jntaimo/2.004-Segway/Segway V7/Segway V7.step

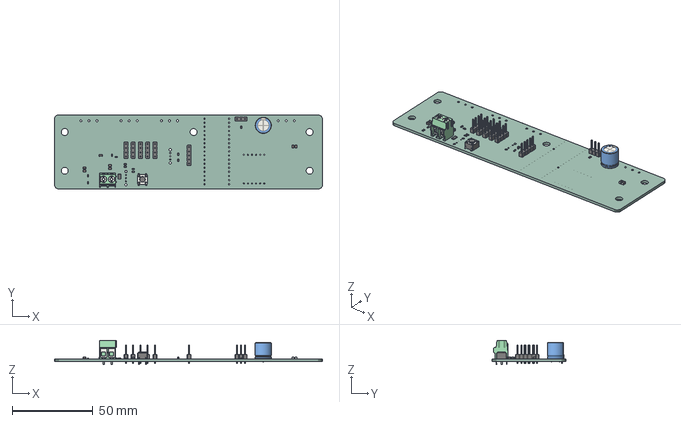
[picture p7: CAD file, 2024-01-22]
Segway V7/Segway V7.step
166.3 x 45.9 x 15.0 mm
PCB
