jntaimo/2.004-Segway/Segway V7/SPH0645LM4H-B/SPH0645LM4H-B.step

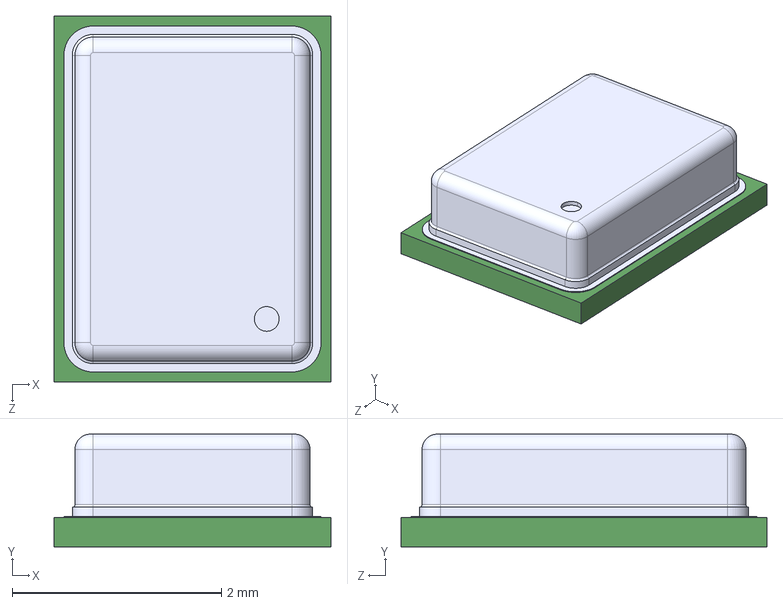
[picture p8: CAD file, 2024-01-22]
Segway V7/SPH0645LM4H-B/SPH0645LM4H-B.step
2.65 x 1.08 x 3.50 mm
