jntaimo/2.004-Segway/Segway V7/TCA9548APWR/TCA9548APWR.step

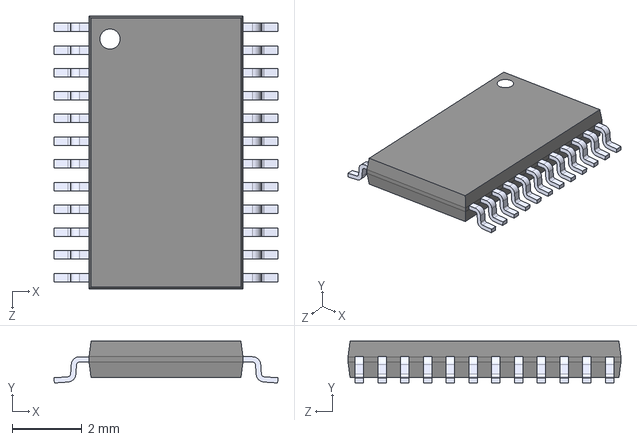
[picture p9: CAD file, 2024-01-22]
Segway V7/TCA9548APWR/TCA9548APWR.step
6.40 x 1.20 x 7.80 mm
