jntaimo/2.004-Segway/Segway V7/TPS564208DDCT/TPS564208DDCT.step

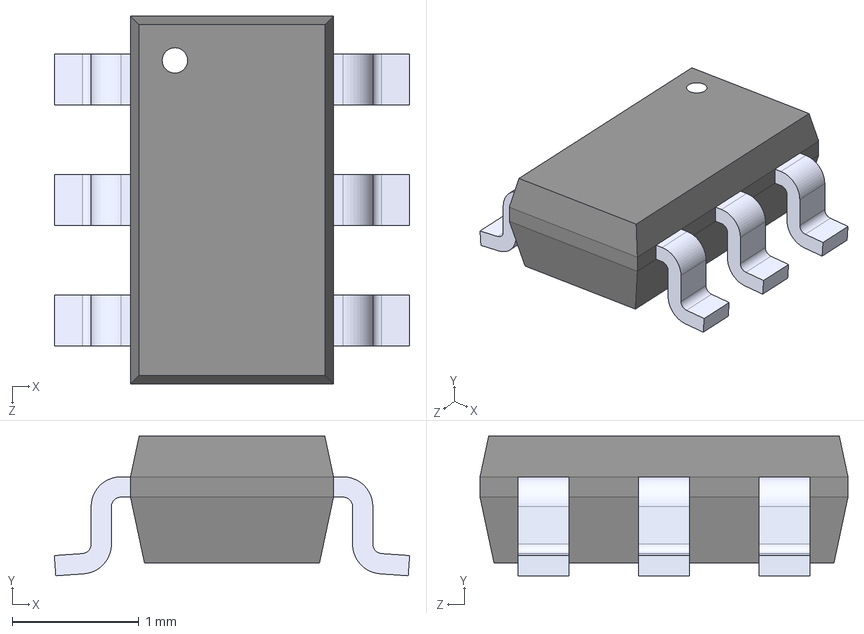
[picture p10: CAD file, 2024-01-22]
Segway V7/TPS564208DDCT/TPS564208DDCT.step
2.80 x 1.10 x 2.90 mm
