jntaimo/2.004-Segway/Segway V7/Segway V7.kicad_pcb

## KiCad design Segway V7/Segway V7.kicad_pcb (2024-01-22)

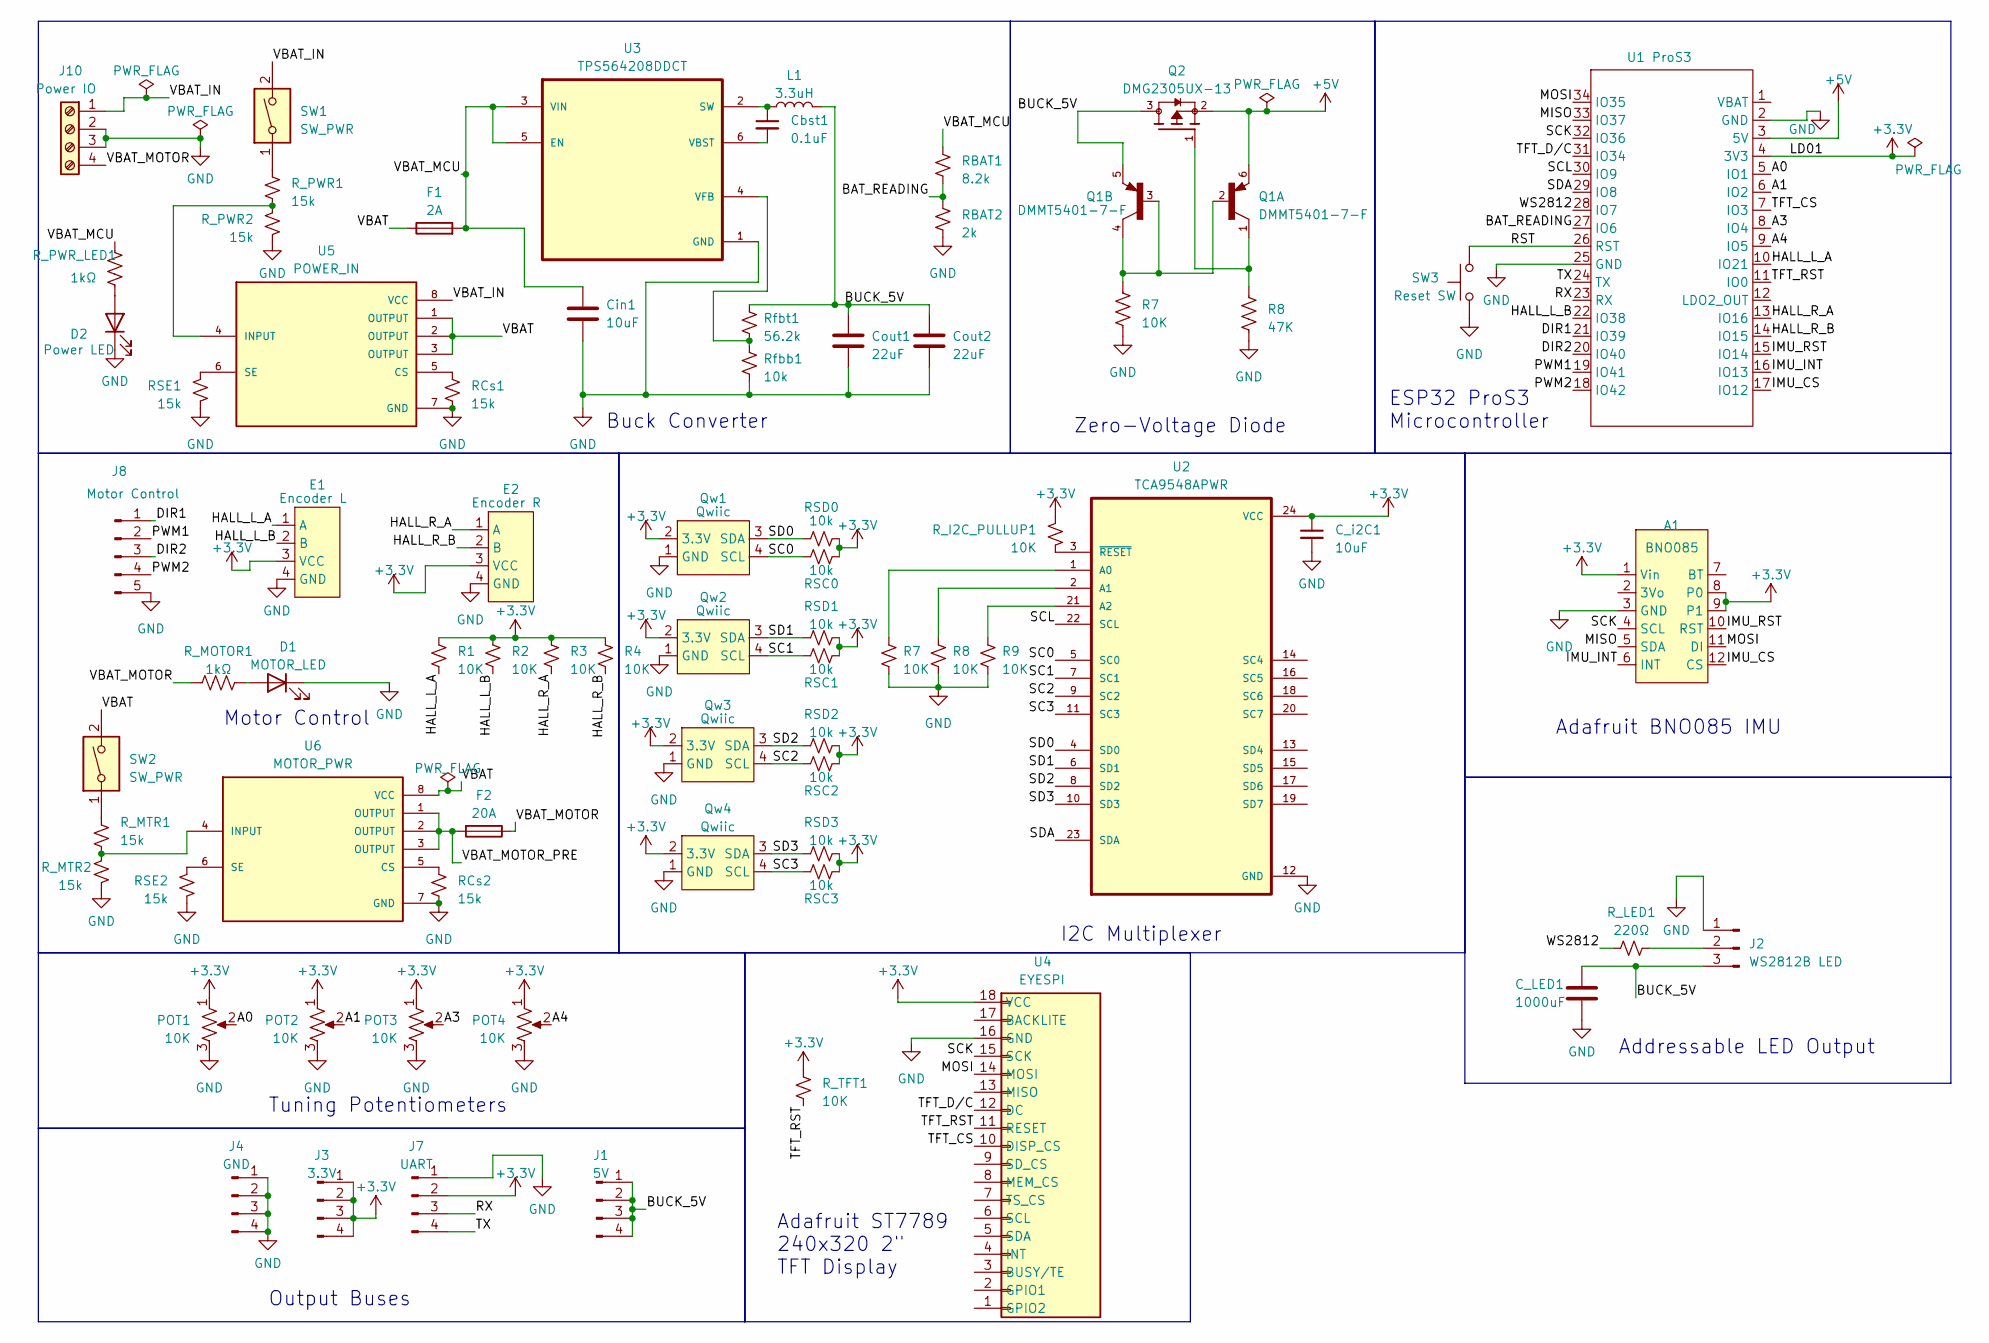
[picture p14: schematic Segway V7.kicad_sch, Segway Bot V7]

Parts:
A1: BNO085; Adafruit_BNO085
C_LED1: 1000uF; CP_Elec_10x12.6; MPN C250086
C_i2C1: 10uF; C_0805_2012Metric_Pad1.18x1.45mm_HandSolder; MPN C39232
Cbst1: 0.1uF; C_0805_2012Metric; MPN C519981
Cin1: 10uF; C_1210_3225Metric; MPN C39232
Cout1, Cout2: 22uF; C_1210_3225Metric; MPN C65428
D1: MOTOR_LED; LED_0603_1608Metric; MPN C434423
D2: Power LED; LED_0603_1608Metric; MPN C84263
E1: Encoder L; JST_PH_S4B-PH-SM4-TB_1x04-1MP_P2.00mm_Horizontal; MPN C265102
E2: Encoder R; JST_PH_S4B-PH-SM4-TB_1x04-1MP_P2.00mm_Horizontal; MPN C265102
F1: 2A; Fuse_1206_3216Metric; MPN C355683
F2: 20A; Fuse_1206_3216Metric; MPN C207007
J1: 5V; PinHeader_1x04_P2.54mm_Vertical
J2: WS2812B LED; PinHeader_1x03_P2.54mm_Vertical
J3: 3.3V; PinHeader_1x04_P2.54mm_Vertical
J4: GND; PinHeader_1x04_P2.54mm_Vertical
J7: UART; PinHeader_1x04_P2.54mm_Vertical
J8: Motor Control; PinHeader_1x05_P2.54mm_Vertical
J10: Power IO; TerminalBlock_Phoenix_MKDS-3-4-5.08_1x04_P5.08mm_Horizontal; MPN C3816378
L1: 3.3uH; L_Vishay_IHLP-4040; MPN C845075
POT1, POT2, POT3, POT4: 10K; JST_PH_B3B-PH-SM4-TB_1x03-1MP_P2.00mm_Vertical; MPN C265082
Q1: DMMT5401-7-F; SOT95P285X140-6N; PARTREV 8
Q2: DMG2305UX-13; SOT91P240X110-3N; PARTREV 09/2018
Qw1, Qw2, Qw3, Qw4: Qwiic; JST_SH_BM04B-SRSS-TB_1x04-1MP_P1.00mm_Vertical; MPN C160390
R1, R2, R3, R4, R7, R9: 10K; R_0402_1005Metric; MPN C144807
R8: 47K; R_0402_1005Metric; MPN C25792
RBAT1: 8.2k; R_0402_1005Metric; MPN C25924
RBAT2: 2k; R_0402_1005Metric; MPN C4109
RCs1, RCs2: 15k; R_0402_1005Metric; MPN C25756
RSC0, RSC1, RSC2, RSC3: 10k; R_0402_1005Metric; MPN C144807
RSD0, RSD1, RSD2, RSD3: 10k; R_0402_1005Metric; MPN C144807
RSE1, RSE2: 15k; R_0402_1005Metric; MPN C25756
R_I2C_PULLUP1: 10K; R_0402_1005Metric; MPN C144807
R_LED1: 220Ω; R_0402_1005Metric; MPN C25151
R_MOTOR1: 1kΩ; R_0402_1005Metric; MPN C21190
R_MTR1, R_MTR2: 15k; R_0402_1005Metric; MPN C25756
R_PWR1, R_PWR2: 15k; R_0402_1005Metric; MPN C25756
R_PWR_LED1: 1kΩ; R_0402_1005Metric; MPN C21190
R_TFT1: 10K; R_0402_1005Metric; MPN C144807
Rfbb1: 10k; R_0402_1005Metric; MPN C144807
Rfbt1: 56.2k; R_0402_1005Metric; MPN C183355
SW1, SW2: SW_PWR; JST_PH_B2B-PH-SM4-TB_1x02-1MP_P2.00mm_Vertical; MPN C160352
SW3: Reset SW; SW_PUSH_6mm
U1: ProS3; ProS3_TH
U2: TCA9548APWR; SOP65P640X120-24N; MPN C130026
U3: TPS564208DDCT; SOT95P280X110-6N; MPN C2070774
U4: EYESPI; Hirose_FH12-18S-0.5SH_1x18-1MP_P0.50mm_Horizontal; MPN C2856802
U5: POWER_IN; DPAK85P972X240-8N; MPN C2150194
U6: MOTOR_PWR; DPAK85P972X240-8N; MPN C2150194

Connections:
+3.3V: A1.1 (Vin), A1.8 (P0), A1.9 (P1), C_i2C1.1, E1.3 (VCC), E2.3 (VCC), J3.1, J3.2, J3.3, J3.4, J7.2, POT1.1, POT2.1, POT3.1, POT4.1, Qw1.2 (3.3V), Qw2.2 (3.3V), Qw3.2 (3.3V), Qw4.2 (3.3V), R1.1, R2.1, R3.1, R4.1, RSC0.2, RSC1.2, RSC2.2, RSC3.2, RSD0.2, RSD1.2, RSD2.2, RSD3.2, R_I2C_PULLUP1.1, R_TFT1.1, U1.4 (3V3), U2.24 (VCC), U4.18 (VCC)
+5V: Q1.6, Q2.2, U1.3 (5V)
/A0: POT1.2, U1.5 (IO1)
/A1: POT2.2, U1.6 (IO2)
/A3: POT3.2, U1.8 (IO4)
/A4: POT4.2, U1.9 (IO5)
/BAT_READING: RBAT1.2, RBAT2.1, U1.27 (IO6)
/BUCK_5V: C_LED1.1, Cout1.1, Cout2.1, J1.1, J1.2, J1.3, J1.4, J2.3, L1.2, Q1.5, Q2.3, Rfbt1.1
/DIR1: J8.1, U1.21 (IO39)
/DIR2: J8.3, U1.20 (IO40)
/HALL_L_A: E1.1 (A), R1.2, U1.10 (IO21)
/HALL_L_B: E1.2 (B), R2.2, U1.22 (IO38)
/HALL_R_A: E2.1 (A), R3.2, U1.13 (IO16)
/HALL_R_B: E2.2 (B), R4.2, U1.14 (IO15)
/IMU_CS: A1.12 (CS), U1.17 (IO12)
/IMU_INT: A1.6 (INT), U1.16 (IO13)
/IMU_RST: A1.10 (RST), U1.15 (IO14)
/MISO: A1.5 (SDA), U1.33 (IO37)
/MOSI: A1.11 (DI), U1.34 (IO35), U4.14 (MOSI)
/PWM1: J8.2, U1.19 (IO41)
/PWM2: J8.4, U1.18 (IO42)
/RST: SW3.1, U1.26 (RST)
/RX: J7.3, U1.23 (RX)
/SC0: Qw1.4 (SCL), RSC0.1, U2.5 (SC0)
/SC1: Qw2.4 (SCL), RSC1.1, U2.7 (SC1)
/SC2: Qw3.4 (SCL), RSC2.1, U2.9 (SC2)
/SC3: Qw4.4 (SCL), RSC3.1, U2.11 (SC3)
/SCK: A1.4 (SCL), U1.32 (IO36), U4.15 (SCK)
/SCL: U1.30 (IO9), U2.22 (SCL)
/SD0: Qw1.3 (SDA), RSD0.1, U2.4 (SD0)
/SD1: Qw2.3 (SDA), RSD1.1, U2.6 (SD1)
/SD2: Qw3.3 (SDA), RSD2.1, U2.8 (SD2)
/SD3: Qw4.3 (SDA), RSD3.1, U2.10 (SD3)
/SDA: U1.29 (IO8), U2.23 (SDA)
/TFT_CS: U1.7 (IO3), U4.10 (DISP_CS)
/TFT_D/C: U1.31 (IO34), U4.12 (DC)
/TFT_RST: R_TFT1.2, U1.11 (IO0), U4.11 (RESET)
/TX: J7.4, U1.24 (TX)
/VBAT: F1.1, SW2.2, U5.1 (OUTPUT), U5.2 (OUTPUT), U5.3 (OUTPUT), U6.8 (VCC)
/VBAT_IN: J10.1, SW1.2, U5.8 (VCC)
/VBAT_MCU: Cin1.1, F1.2, RBAT1.1, R_PWR_LED1.2, U3.3 (VIN), U3.5 (EN)
/VBAT_MOTOR: F2.1, J10.4, R_MOTOR1.1
/VBAT_MOTOR_PRE: F2.2, U6.1 (OUTPUT), U6.2 (OUTPUT), U6.3 (OUTPUT)
/WS2812: R_LED1.1, U1.28 (IO7)
GND: A1.3 (GND), C_LED1.2, C_i2C1.2, Cin1.2, Cout1.2, Cout2.2, D1.1 (K), D2.1 (K), E1.4 (GND), E2.4 (GND), J2.1, J4.1, J4.2, J4.3, J4.4, J7.1, J8.5, J10.2, J10.3, POT1.3, POT2.3, POT3.3, POT4.3, Qw1.1 (GND), Qw2.1 (GND), Qw3.1 (GND), Qw4.1 (GND), R7.2, R8.2, R9.2, RBAT2.2, RCs1.2, RCs2.2, RSE1.2, RSE2.2, R_MTR2.2, R_PWR2.2, Rfbb1.2, SW3.2, U1.2 (GND), U1.25 (GND), U2.12 (GND), U3.1 (GND), U4.16 (GND), U5.7 (GND), U6.7 (GND); also elsewhere on the board
unnamed: D1.2 (A), R_MOTOR1.2
unnamed: D2.2 (A), R_PWR_LED1.1
unnamed: J2.2, R_LED1.2
unnamed: R_MTR1.1, SW2.1
unnamed: R_PWR1.1, SW1.1
unnamed: R9.1, U2.21 (A2)
unnamed: R_I2C_PULLUP1.2, U2.3 (~RESET)
unnamed: Cbst1.1, L1.1, U3.2 (SW)
unnamed: Cbst1.2, U3.6 (VBST)
unnamed: Rfbb1.1, Rfbt1.2, U3.4 (VFB)
unnamed: RCs1.1, U5.5 (CS)
unnamed: R_PWR1.2, R_PWR2.1, U5.4 (INPUT)
unnamed: RSE1.1, U5.6 (SE)
unnamed: RCs2.1, U6.5 (CS)
unnamed: R_MTR1.2, R_MTR2.1, U6.4 (INPUT)
unnamed: RSE2.1, U6.6 (SE)

Notes on the sheet:
Motor Control
Output Buses
Zero-Voltage Diode
Adafruit ST7789 240x320 2" TFT Display
ESP32 ProS3 Microcontroller
I2C Multiplexer
Tuning Potentiometers
Buck Converter
Adafruit BNO085 IMU
Addressable LED Output

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
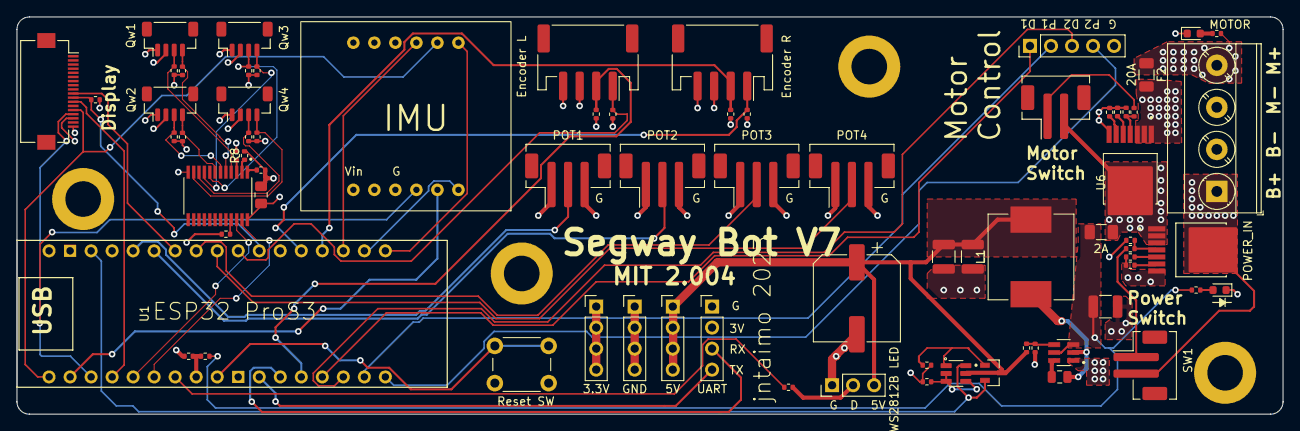
[picture p15: board Segway V7.kicad_pcb from above]

Board: 4 copper layers, 153.0 x 48.0 mm, 74 parts (0 on the bottom side), 65 nets.

Other parts of the board:
R_ZVD_1: 10K; R_0402_1005Metric
R_ZVD_2: 47K; R_0402_1005Metric

Their connections:
GND: R_ZVD_1.2, R_ZVD_2.2; also elsewhere on the board
