jntaimo/2.004-Segway/Segway V7/esp32s3-main/code/micropython/helper libraries/feathers3/feathers3.py

# FeatherS3 MicroPython Helper Library
# 2022 Seon Rozenblum - Unexpected Maker
#
# Project home:
# http://feathers3.io

# Import required libraries
from micropython import const
from machine import Pin, ADC
import time

# FeatherS3 Hardware Pin Assignments

# Sense Pins
VBUS_SENSE = const(34)
VBAT_SENSE = const(2)

# RGB LED, LDO2 & Other Pins
RGB_DATA = const(40)
LDO2 = const(39)
LED = const(13)
AMB_LIGHT = const(4)

# SPI
SPI_MOSI = const(35)
SPI_MISO = const(37)
SPI_CLK = const(36)

# I2C
I2C_SDA = const(8)
I2C_SCL = const(9)

# Helper functions

# LED & Ambient Light Sensor control
def led_set(state):
    """Set the state of the BLUE LED on IO13"""
    l = Pin(LED, Pin.OUT)
    l.value(state)


def led_blink():
    """Toggle the BLUE LED on IO13"""
    l = Pin(LED, Pin.OUT)
    l.value(not l.value())


# Create ADC and set attenuation and return the ambient light value from the onboard sensor
def get_amb_light():
    """Get Ambient Light Sensor reading"""
    adc = ADC(Pin(AMB_LIGHT))
    adc.atten(ADC.ATTN_11DB)
    return adc.read()


def set_ldo2_power(state):
    """Enable or Disable power to the second LDO"""
    Pin(LDO2, Pin.OUT).value(state)


def get_battery_voltage():
    """
    Returns the current battery voltage. If no battery is connected, returns 4.2V which is the charge voltage
    This is an approximation only, but useful to detect if the charge state of the battery is getting low.
    """
    adc = ADC(Pin(VBAT_SENSE))  # Assign the ADC pin to read
    # We are going to read the ADC 10 times and discard the results as we can't guarantee the ADC is calibrated or stable yet after boot. Not sure why we have to do this :(
    for _ in range(10):
        adc.read()
    measuredvbat = adc.read()
    measuredvbat /= 4095  # divide by 4095 as we are using the default ADC voltage range of 0-1.2V
    measuredvbat *= 4.2  # Multiply by 4.2V, our max charge voltage for a 1S LiPo
    return round(measuredvbat, 2)


def get_vbus_present():
    """Detect if VBUS (5V) power source is present"""
    return Pin(VBUS_SENSE, Pin.IN).value() == 1


# NeoPixel rainbow colour wheel
def rgb_color_wheel(wheel_pos):
    """Color wheel to allow for cycling through the rainbow of RGB colors."""
    wheel_pos = wheel_pos % 255

    if wheel_pos < 85:
        return 255 - wheel_pos * 3, 0, wheel_pos * 3
    elif wheel_pos < 170:
        wheel_pos -= 85
        return 0, wheel_pos * 3, 255 - wheel_pos * 3
    else:
        wheel_pos -= 170
        return wheel_pos * 3, 255 - wheel_pos * 3, 0
